kszlk07/kue/urzadzenie.png

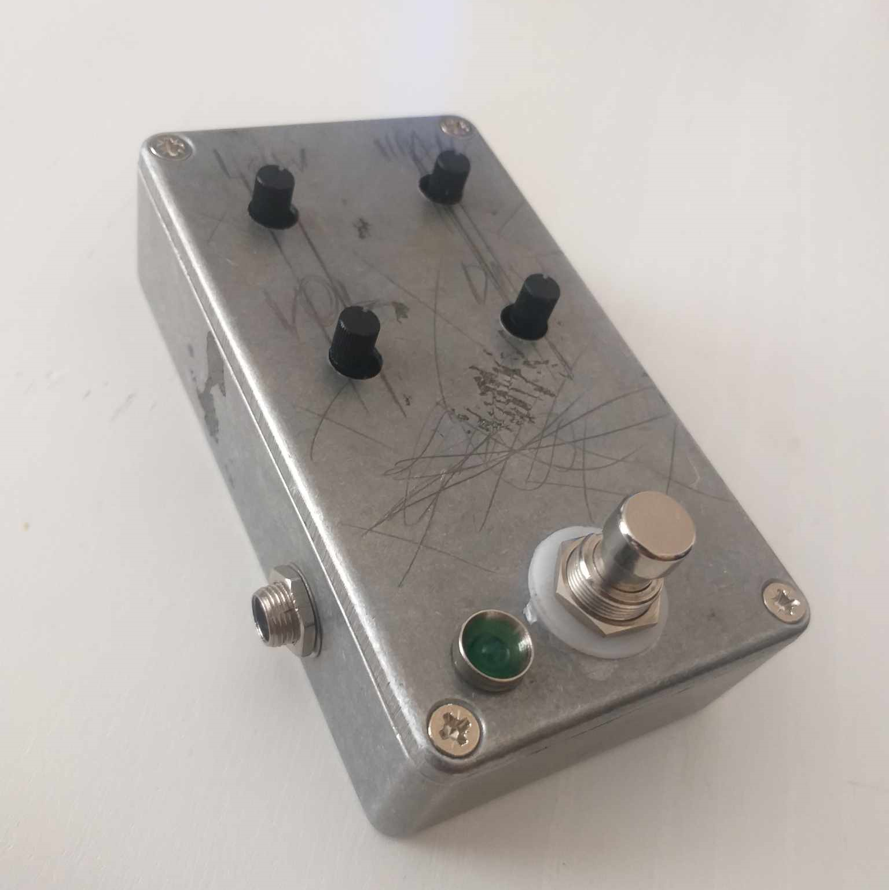
urzadzenie.png
