kszlk07/kue/SwedishChainsaw.kicad_pcb

## KiCad design SwedishChainsaw.kicad_pcb (2023-07-03)

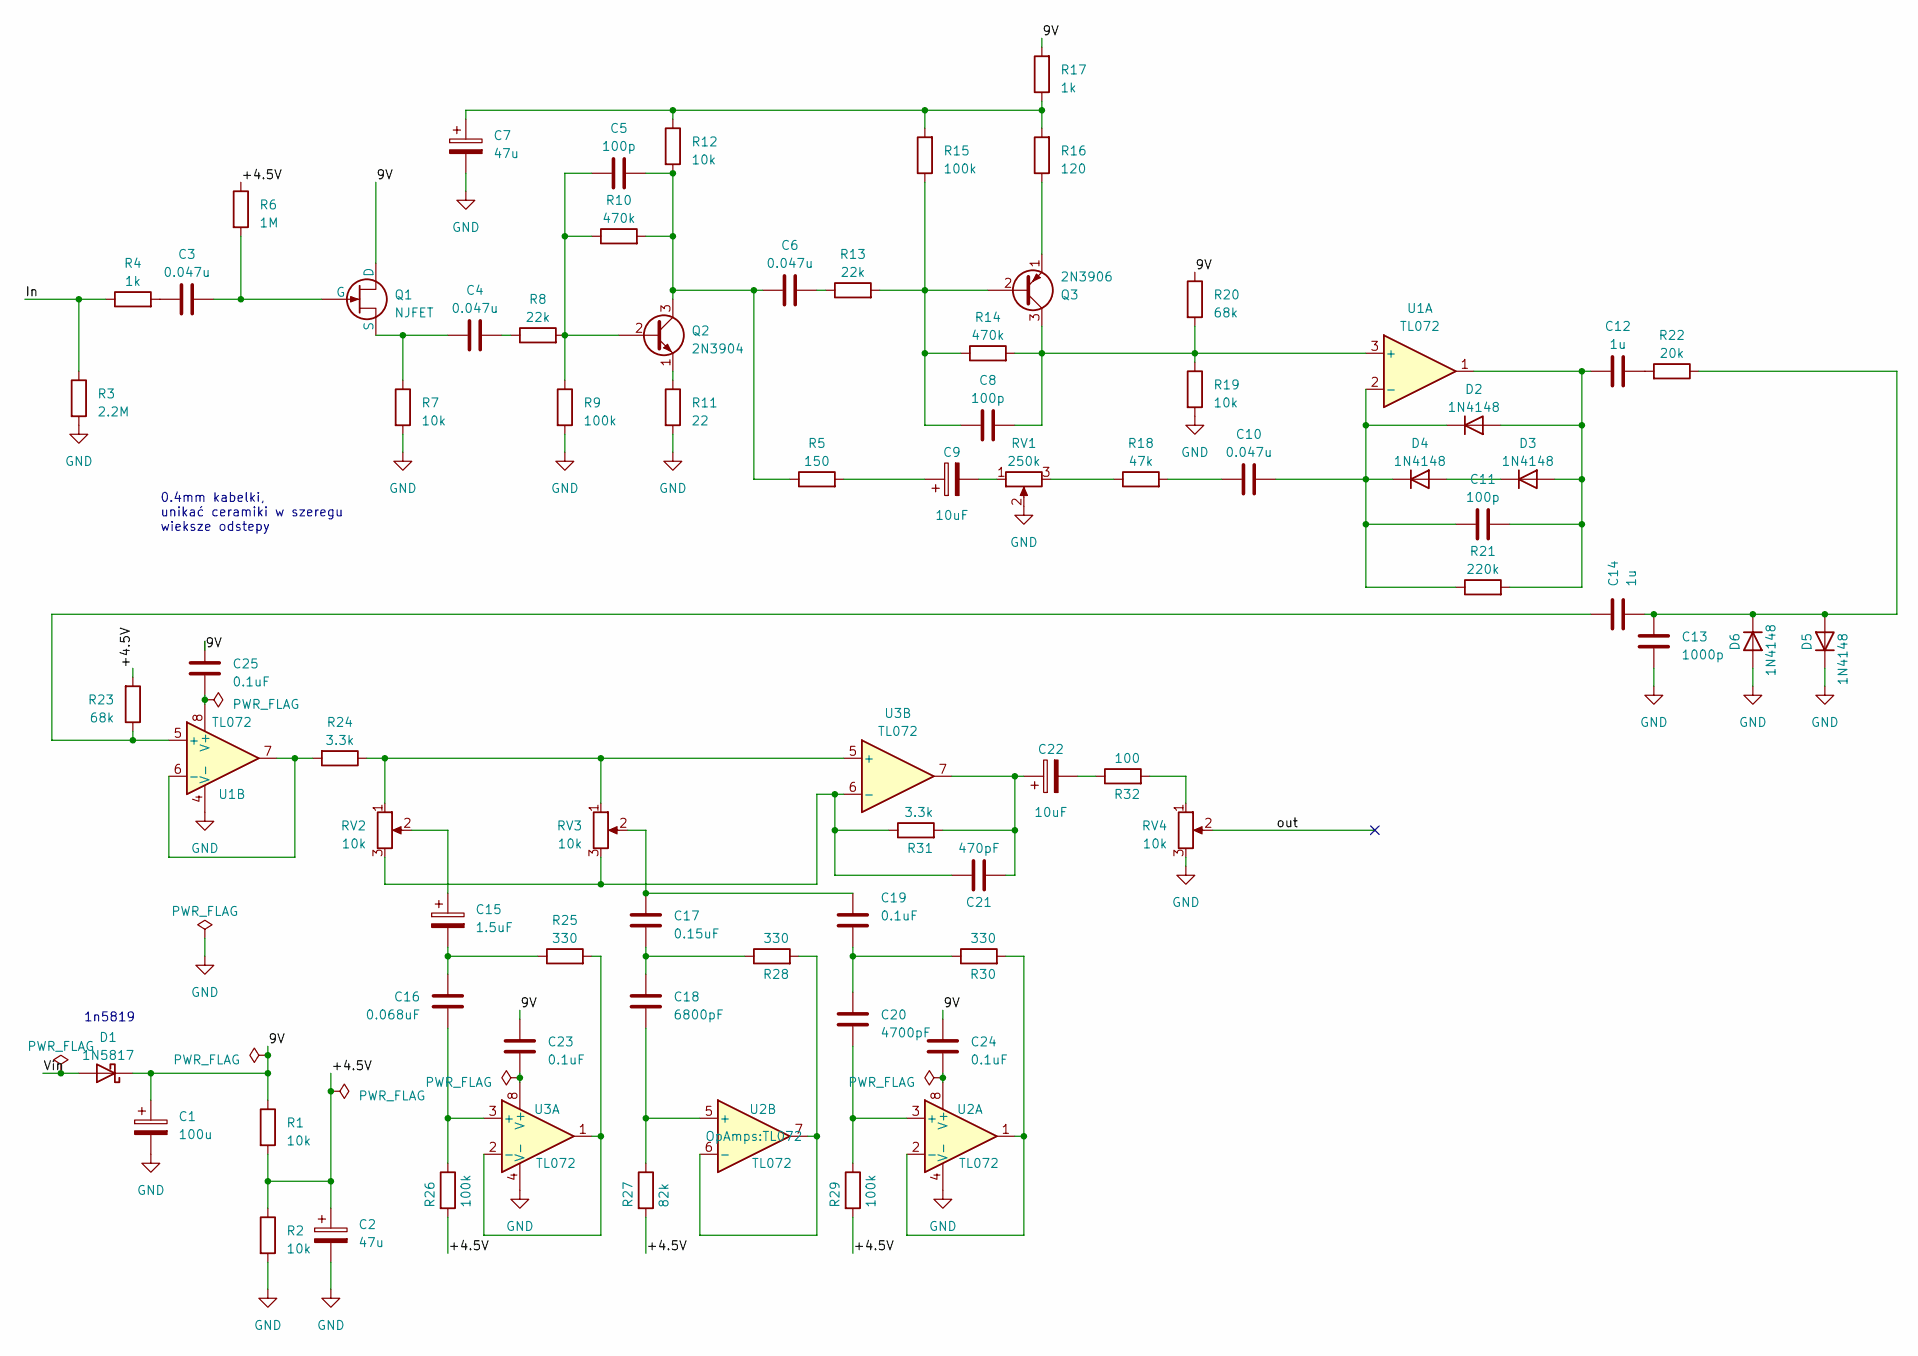
[picture p6: schematic SwedishChainsaw.kicad_sch]

Parts:
C1: 100u; CP_Radial_D6.3mm_P2.50mm
C2, C7: 47u; CP_Radial_D5.0mm_P2.50mm
C3, C4, C6, C10: 0.047u; C_Rect_L7.2mm_W3.0mm_P5.00mm_FKS2_FKP2_MKS2_MKP2
C5, C8, C11: 100p; C_Disc_D4.3mm_W1.9mm_P5.00mm
C9, C22: 10uF; CP_Radial_D5.0mm_P2.00mm
C12, C14: 1u; C_Disc_D7.5mm_W5.0mm_P5.00mm
C13: 1000p; C_Disc_D4.7mm_W2.5mm_P5.00mm
C15: 1.5uF; CP_Radial_D4.0mm_P1.50mm
C16: 0.068uF; C_Disc_D5.1mm_W3.2mm_P5.00mm
C17: 0.15uF; C_Disc_D5.1mm_W3.2mm_P5.00mm
C18: 6800pF; C_Disc_D6.0mm_W4.4mm_P5.00mm
C19, C23, C24: 0.1uF; C_Disc_D5.0mm_W2.5mm_P5.00mm
C20: 4700pF; C_Disc_D6.0mm_W4.4mm_P5.00mm
C21: 470pF; C_Disc_D4.3mm_W1.9mm_P5.00mm
C25: 0.1uF; C_Disc_D5.1mm_W3.2mm_P5.00mm
D1: 1N5817; D_DO-41_SOD81_P10.16mm_Horizontal
D2, D3, D4, D5, D6: 1N4148; D_A-405_P7.62mm_Horizontal
Q1: NJFET; TO-92_Inline_Wide
Q2: 2N3904; TO-92_Inline_Wide
Q3: 2N3906; TO-92_Inline_Wide
R1, R2, R7, R12, R19: 10k; R_Axial_DIN0204_L3.6mm_D1.6mm_P5.08mm_Horizontal
R3: 2.2M; R_Axial_DIN0204_L3.6mm_D1.6mm_P5.08mm_Horizontal
R4, R17: 1k; R_Axial_DIN0204_L3.6mm_D1.6mm_P5.08mm_Horizontal
R5: 150; R_Axial_DIN0204_L3.6mm_D1.6mm_P7.62mm_Horizontal
R6: 1M; R_Axial_DIN0204_L3.6mm_D1.6mm_P5.08mm_Horizontal
R8, R13: 22k; R_Axial_DIN0204_L3.6mm_D1.6mm_P7.62mm_Horizontal
R9, R15, R26, R29: 100k; R_Axial_DIN0204_L3.6mm_D1.6mm_P5.08mm_Horizontal
R10, R14: 470k; R_Axial_DIN0204_L3.6mm_D1.6mm_P5.08mm_Horizontal
R11: 22; R_Axial_DIN0204_L3.6mm_D1.6mm_P7.62mm_Horizontal
R16: 120; R_Axial_DIN0204_L3.6mm_D1.6mm_P7.62mm_Horizontal
R18: 47k; R_Axial_DIN0204_L3.6mm_D1.6mm_P5.08mm_Horizontal
R20, R23: 68k; R_Axial_DIN0204_L3.6mm_D1.6mm_P7.62mm_Horizontal
R21: 220k; R_Axial_DIN0204_L3.6mm_D1.6mm_P5.08mm_Horizontal
R22: 20k; R_Axial_DIN0204_L3.6mm_D1.6mm_P5.08mm_Horizontal
R24, R31: 3.3k; R_Axial_DIN0204_L3.6mm_D1.6mm_P7.62mm_Horizontal
R25, R28, R30: 330; R_Axial_DIN0204_L3.6mm_D1.6mm_P5.08mm_Horizontal
R27: 82k; R_Axial_DIN0204_L3.6mm_D1.6mm_P5.08mm_Horizontal
R32: 100; R_Axial_DIN0204_L3.6mm_D1.6mm_P5.08mm_Horizontal
RV1: 250k; Potentiometer_Alpha_RD901F-40-00D_Single_Vertical_CircularH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
RV2, RV3, RV4: 10k; Potentiometer_Alpha_RD901F-40-00D_Single_Vertical_CircularH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
U1, U2, U3: TL072

Connections:
/9V: C1.1, C23.1, C24.1, C25.1, D1.1 (K), Q1.1 (D), R1.1, R17.2, R20.1
/+4.5V: C2.1, R1.2, R2.1, R6.1, R23.2, R26.2, R27.2, R29.2
/In: R3.1, R4.1; also elsewhere on the board
/Vin: D1.2 (A); also elsewhere on the board
/out: RV4.2; also elsewhere on the board
GND: C1.2, C2.2, C7.2, C13.1, D5.1 (K), D6.2 (A), R2.2, R3.2, R7.2, R9.2, R11.2, R19.2, RV1.2, RV4.3, U1.4 (V-), U2.4 (V-), U3.4 (V-); also elsewhere on the board
unnamed: C3.1, R4.2
unnamed: C4.2, R8.1
unnamed: C6.2, R13.1
unnamed: C7.1, R12.1, R15.2, R16.2, R17.1
unnamed: C9.1, R5.2
unnamed: C9.2, RV1.1
unnamed: C10.1, R18.2
unnamed: C12.2, R22.2
unnamed: C15.1, RV2.2
unnamed: C15.2, C16.2, R25.1
unnamed: C17.1, C18.2, R28.1
unnamed: C17.2, C19.2, RV3.2
unnamed: C19.1, C20.2, R30.1
unnamed: C21.1, C22.1, R31.2, U3.7
unnamed: C22.2, R32.1
unnamed: C11.2, C12.1, D2.2 (A), D3.2 (A), R21.2, U1.1
unnamed: C10.2, C11.1, D2.1 (K), D4.1 (K), R21.1, U1.2 (-)
unnamed: D3.1 (K), D4.2 (A)
unnamed: C13.2, C14.1, D5.2 (A), D6.1 (K), R22.1
unnamed: C3.2, Q1.2 (G), R6.2
unnamed: C4.1, Q1.3 (S), R7.1
unnamed: C5.1, Q2.2 (B), R8.2, R9.1, R10.1
unnamed: C5.2, C6.1, Q2.3 (C), R5.1, R10.2, R12.2
unnamed: Q2.1 (E), R11.1
unnamed: C8.1, Q3.2 (B), R13.2, R14.1, R15.1
unnamed: C8.2, Q3.3 (C), R14.2, R19.1, R20.2, U1.3 (+)
unnamed: Q3.1 (E), R16.1
unnamed: R18.1, RV1.3
unnamed: R32.2, RV4.1
unnamed: C14.2, R23.1, U1.5 (+)
unnamed: R24.2, U1.6 (-), U1.7
unnamed: C25.2, U1.8 (V+)
unnamed: C20.1, R29.1, U2.3 (+)
unnamed: R30.2, U2.1, U2.2 (-)
unnamed: C18.1, R27.1, U2.5 (+)
unnamed: R28.2, U2.6 (-), U2.7
unnamed: C24.2, U2.8 (V+)
unnamed: C16.1, R26.1, U3.3 (+)
unnamed: R25.2, U3.1, U3.2 (-)
unnamed: R24.1, RV2.1, RV3.1, U3.5 (+)
unnamed: C21.2, R31.1, RV2.3, RV3.3, U3.6 (-)
unnamed: C23.2, U3.8 (V+)

Notes on the sheet:
1n5819
0.4mm kabelki, unikać ceramiki w szeregu wieksze odstepy

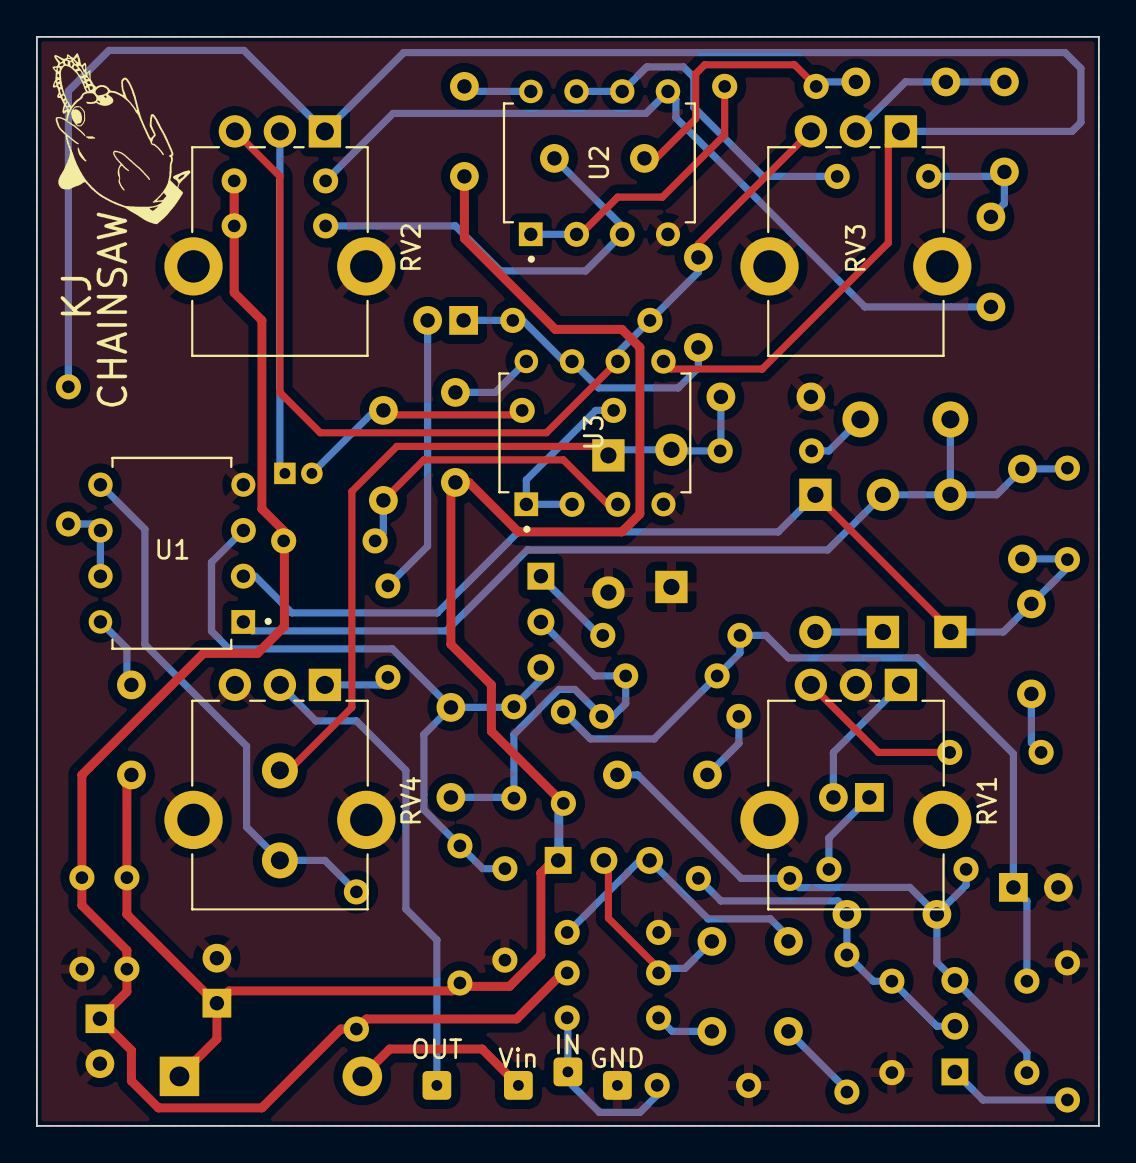
[picture p7: board SwedishChainsaw.kicad_pcb from above]

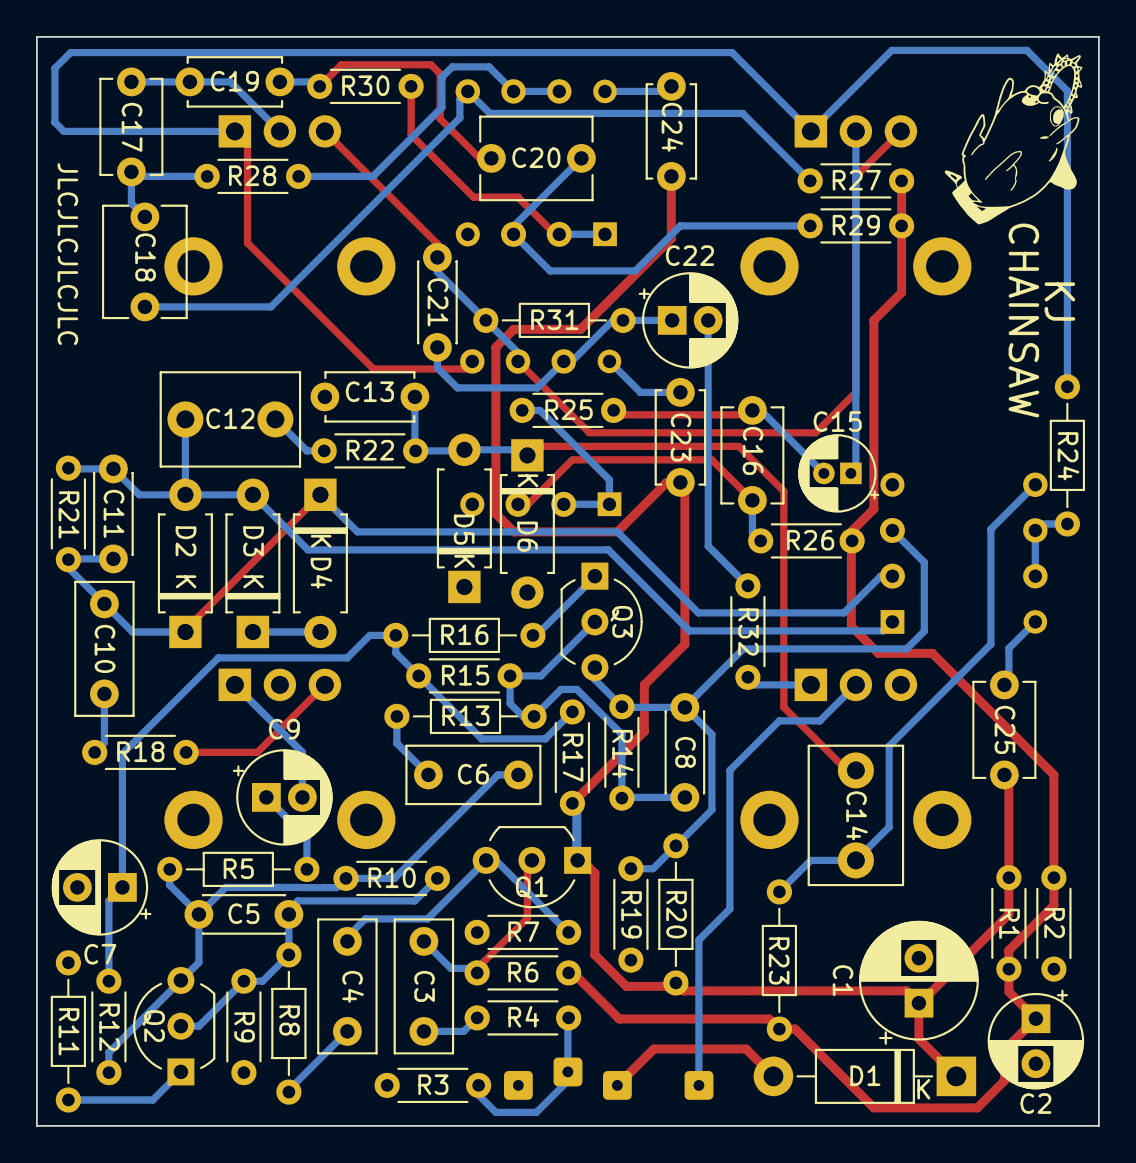
[picture p8: board SwedishChainsaw.kicad_pcb from below]

Board: 2 copper layers, 59.0 x 60.5 mm, 77 parts (66 on the bottom side), 48 nets.

Other parts of the board:
GND: SolderWire-0.1sqmm_1x01_D0.4mm_OD1mm
IN: SolderWire-0.1sqmm_1x01_D0.4mm_OD1mm
OUT: SolderWire-0.1sqmm_1x01_D0.4mm_OD1mm
Vin: SolderWire-0.1sqmm_1x01_D0.4mm_OD1mm

Their connections:
/In: IN.1; also elsewhere on the board
/Vin: Vin.1; also elsewhere on the board
/out: OUT.1; also elsewhere on the board
GND: GND.1; also elsewhere on the board
